ivenguzel/EE463-Hardware_Project/PWM test results/WhatsApp Image 2019-01-11 at 16.16.13.jpeg

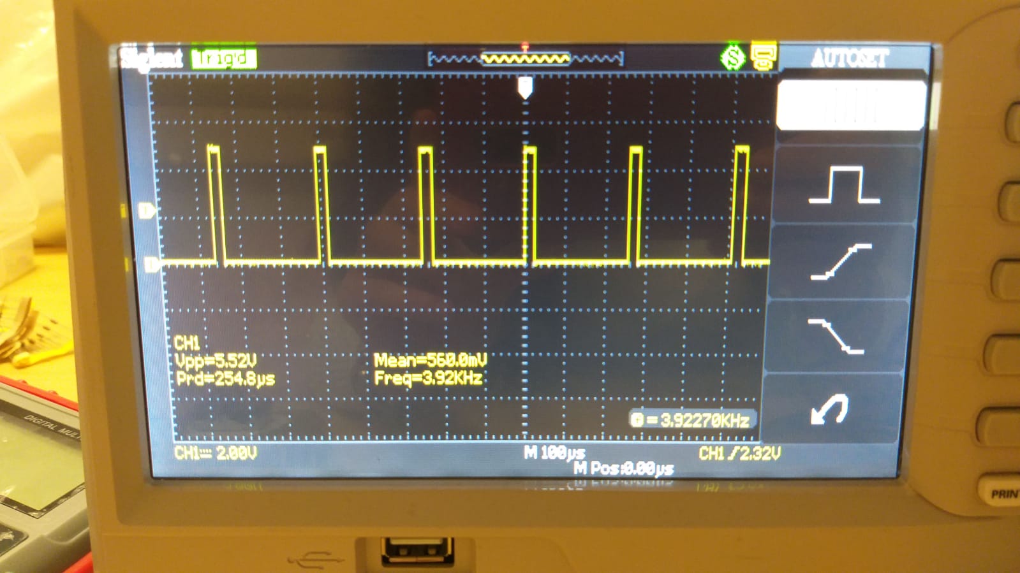
PWM test results/WhatsApp Image 2019-01-11 at 16.16.13.jpeg
