ivenguzel/EE463-Hardware_Project/igbt çalışıyooo/WhatsApp Image 2019-01-19 at 15.50.36.jpeg

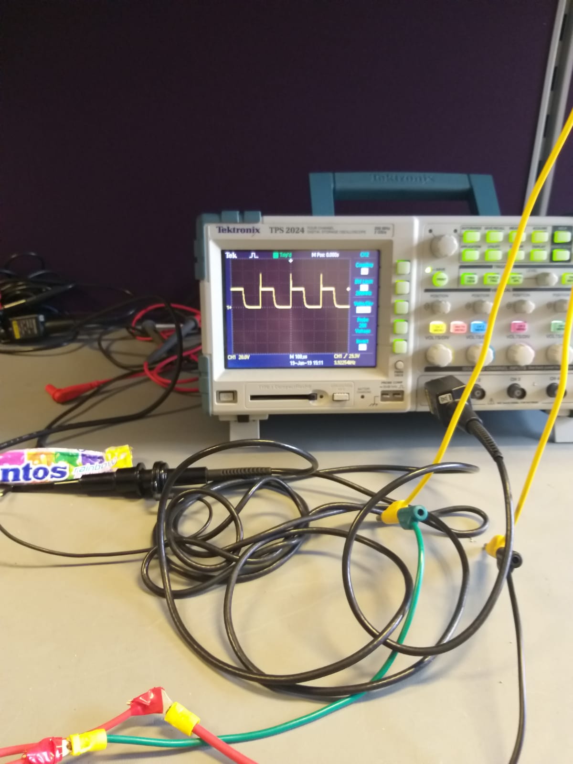
igbt çalışıyooo/WhatsApp Image 2019-01-19 at 15.50.36.jpeg
