ivenguzel/EE463-Hardware_Project/opto çalışıyooo/WhatsApp Image 2019-01-18 at 15.56.46 (1).jpeg

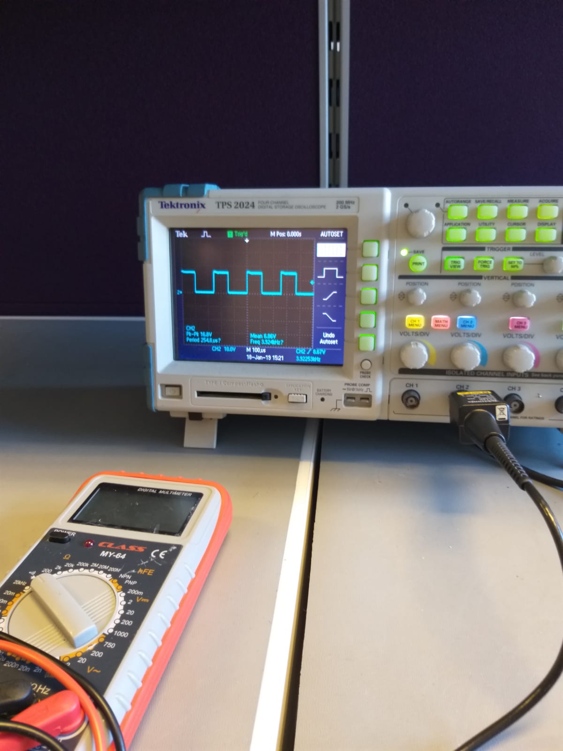
opto çalışıyooo/WhatsApp Image 2019-01-18 at 15.56.46 (1).jpeg
