ivenguzel/EE463-Hardware_Project/(commit log)

2019-01-09 hardware.slx
    Bir önceki tasarım hatalı gibi geldi bunu yaptım. Voltage feedback var
2019-01-09 drive circuit without voltage feedback
2019-01-11 Arduino clock manipulation and PWM code, test results of these
2019-01-19 igbt, FWD, opto connection test: voltage between anode-collecter 30V Results are with and without snubber and capacitor connected
2019-01-19 Final design of the driver
2019-01-21 Arduino duty code: 3.9kHz Increases and decreases duty cycle from0 to 0.7 in half a minute
2019-01-21 soft start corrected: now starts from %5 duty
    [Soft_start_ivo.ino]
2019-01-23 report: topology selection, gate driver
